arpfic/l_depth_r_depth_dx7_eurorack/README.md

# L&R Depth

This folder contains the hardware design and software for a **Left & Right (L&R) Depth module** with a breakpoint/plateau, inspired by the famous DX7 function from Yamaha synthesizers. The goal was to provide a eurorack module that can shape control voltages or signals with separate left/right “depth” ranges, plus an adjustable center plateau zone.

More photos coming soon !

## Hardware

- **Eurorack** (+12/-12V) format (see the [`Hardware`](Hardware/) folder).
- Exposes:
  - **CV input** for the main signal.
  - Pots/sliders for left/right depth and a central “plateau” adjustment.
  - Digital switches/buttons to toggle between **linear** and **exponential** shapes.
- Panel:

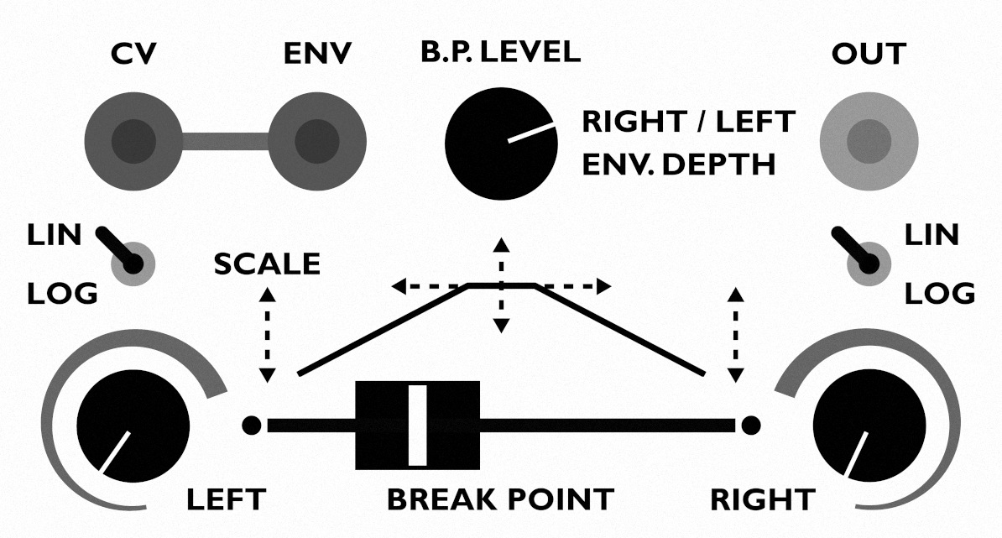
[picture p1: Hardware/lr_pannel.jpg]
LRDepth_pannel


- PCB:

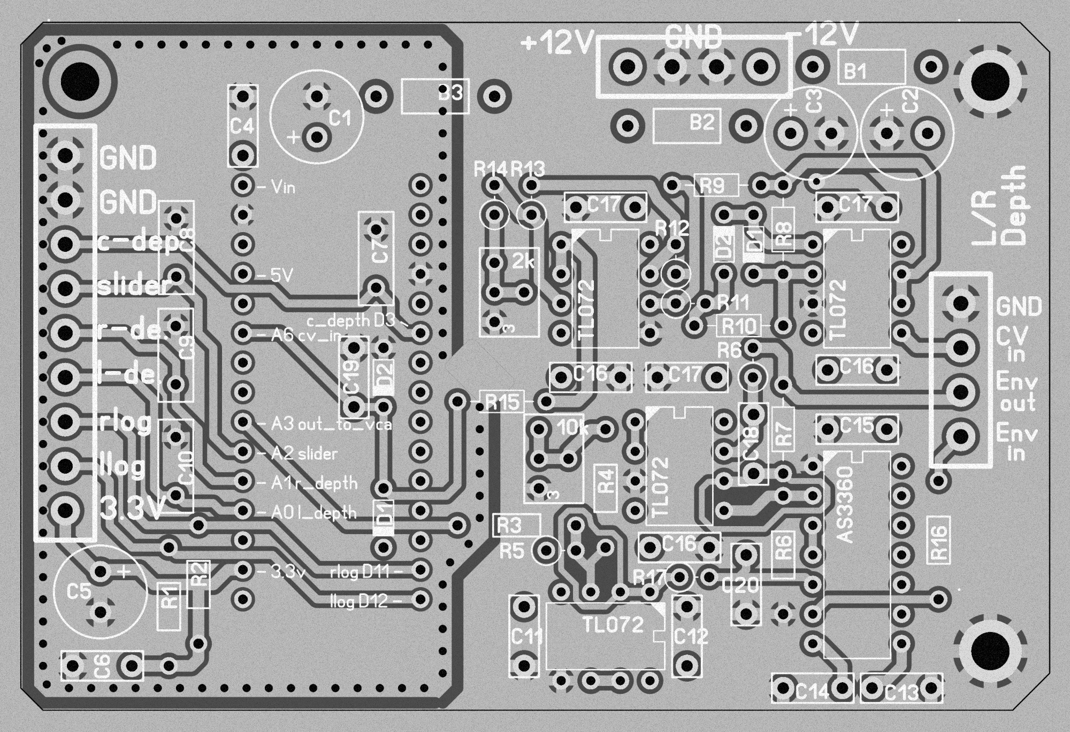
[picture p2: Hardware/lr_depth_top.jpg]
LRDepth_top

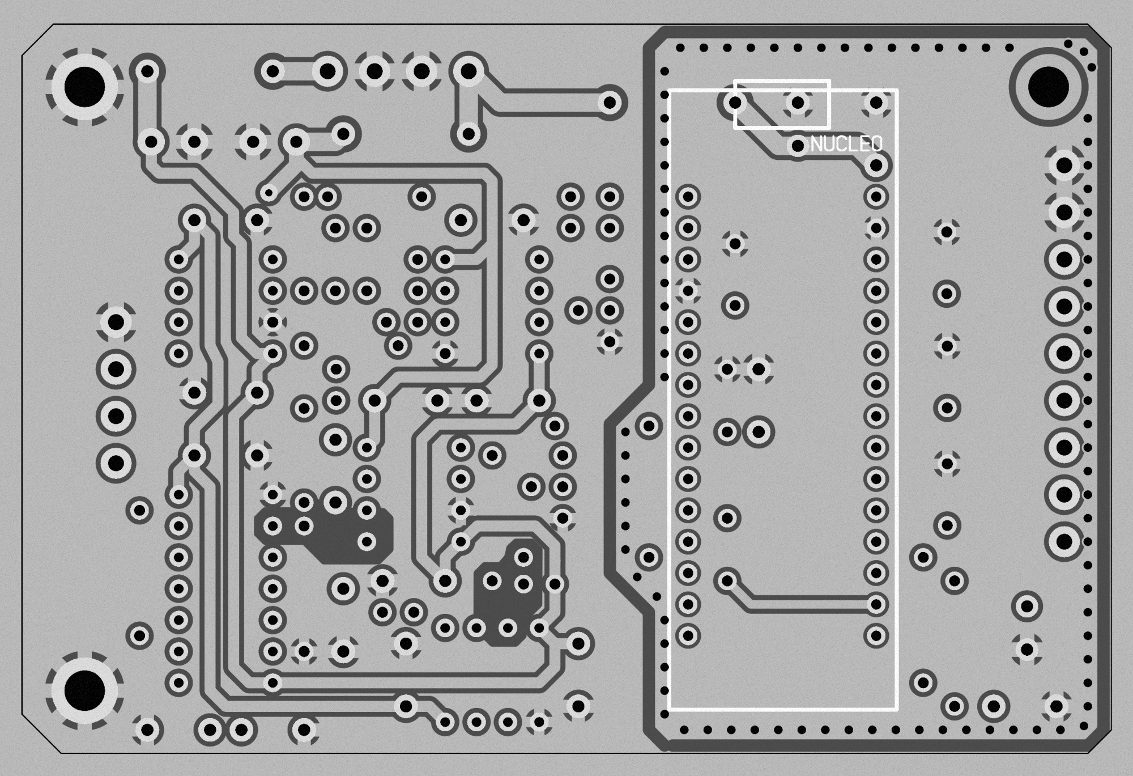
[picture p3: Hardware/lr_depth_bottom.jpg]
LRDepth_bottom


## Software

- Compiled under Mbed using a custom profile (e.g. -O3 optimizations) provided in this repository.

## Example Plots

Here are some example curves generated by the firmware, showing both **linear** and **exponential** transitions:

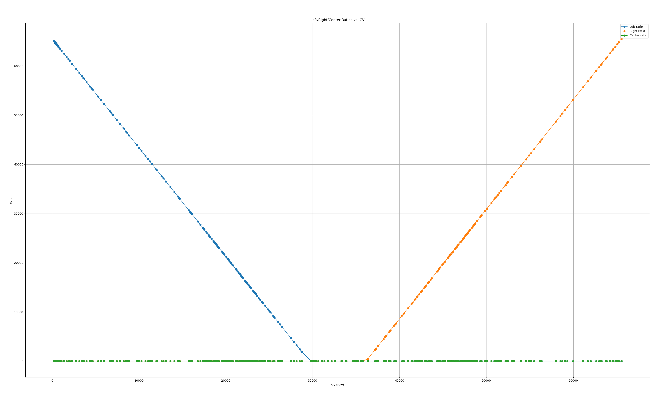
[picture p4: lin_final.png]
Linearcurve
  
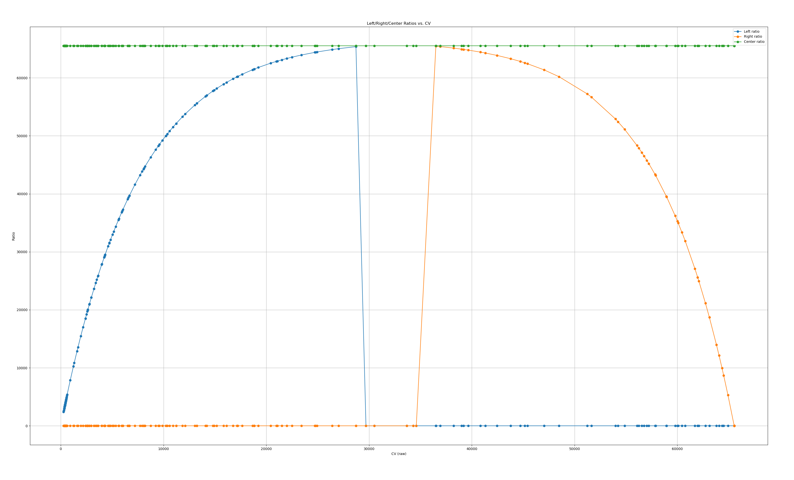
[picture p5: exp_w_c=4_final.png]
Expcurve
  
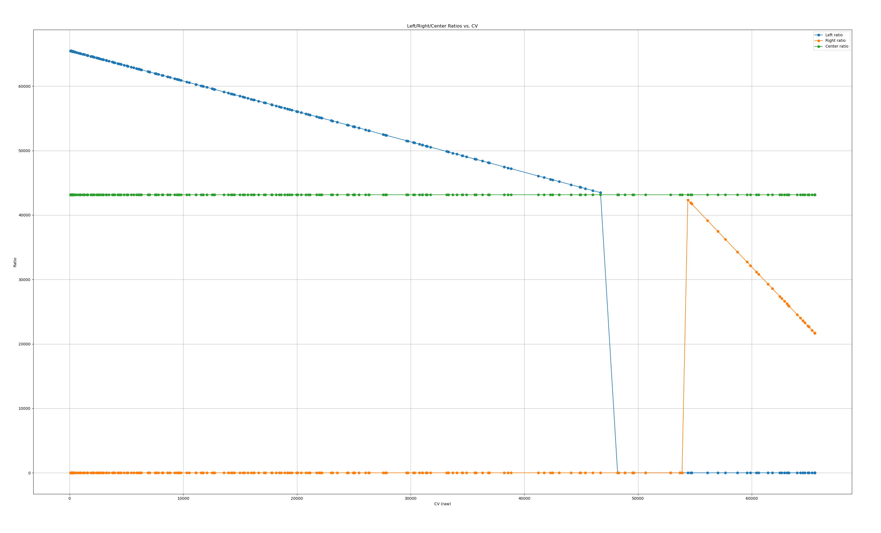
[picture p6: lin_other.png]
Linearother
  
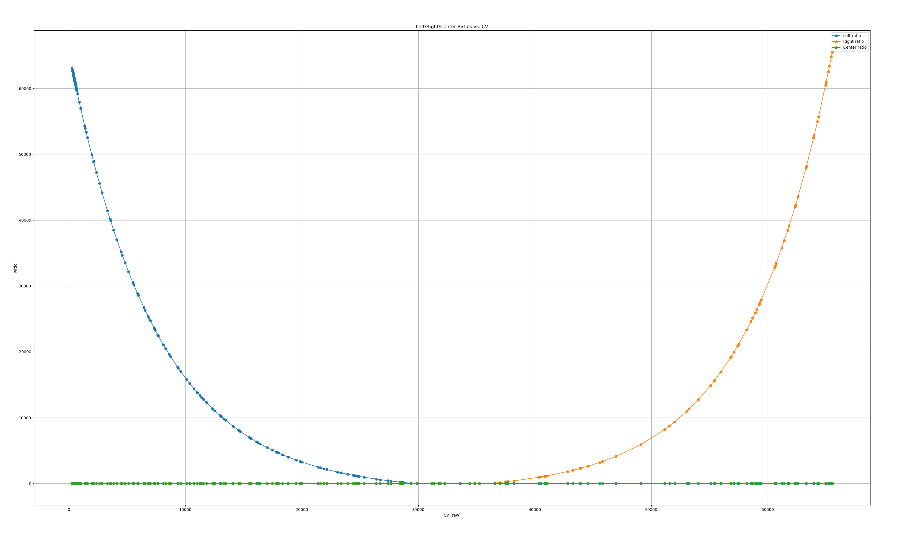
[picture p7: exp_other.png]
Expother

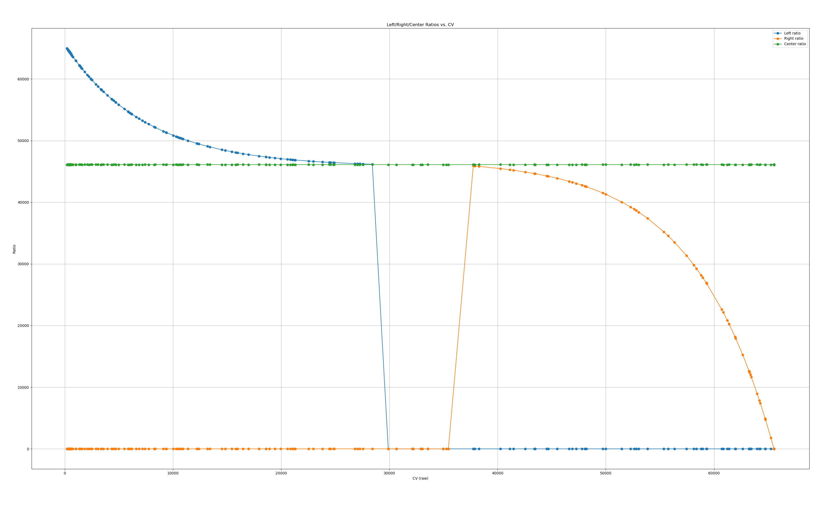
[picture p8: exp_other_2.png]
Expother2

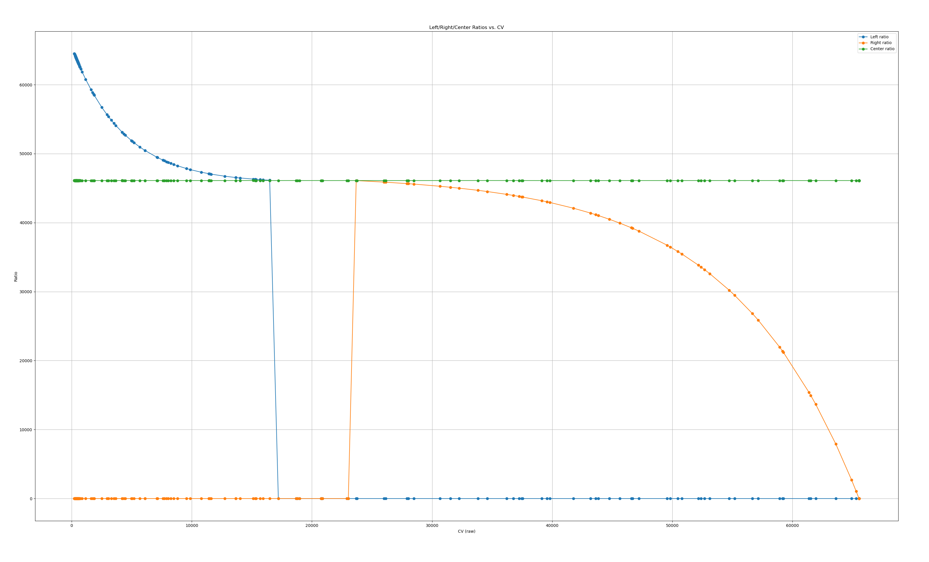
[picture p9: exp_other_3.png]
Expother3


## Notes, Limitations, and futures Improvements:

- **Re-implement center control so it affects only the center plateau** (reducing it without altering the side breakpoints), and apply inverted curves on the side transitions **[ok]**. 
- Mbed: It would be beneficial to migrate away from Mbed toward a lower-level library such as libopencm3 for more direct control.
- ADC (12-bit): Consider using an external ADC with higher resolution—likewise for the DAC—to achieve finer precision.
- Current Loop Speed (~10 kHz): The calculation loop runs at about 10,000 iterations per second, which can limit experimentation if you want to process signals beyond simple CV. To significantly increase throughput, implementing DMA on the ADC inputs would be essential.
- Tests show that floating-point operations are faster than integer operations on this platform.

---

## DX7 Reference

- On the Yamaha DX7, “L & R Depth” parameters control how certain amplitude segments transition on the left or right side of a breakpoint.

---

Principal code maintainer : Damien Leblois <damienleb@protonmail.com>
