arpfic/l_depth_r_depth_dx7_eurorack/Documentation/as3360_to_env_out.png

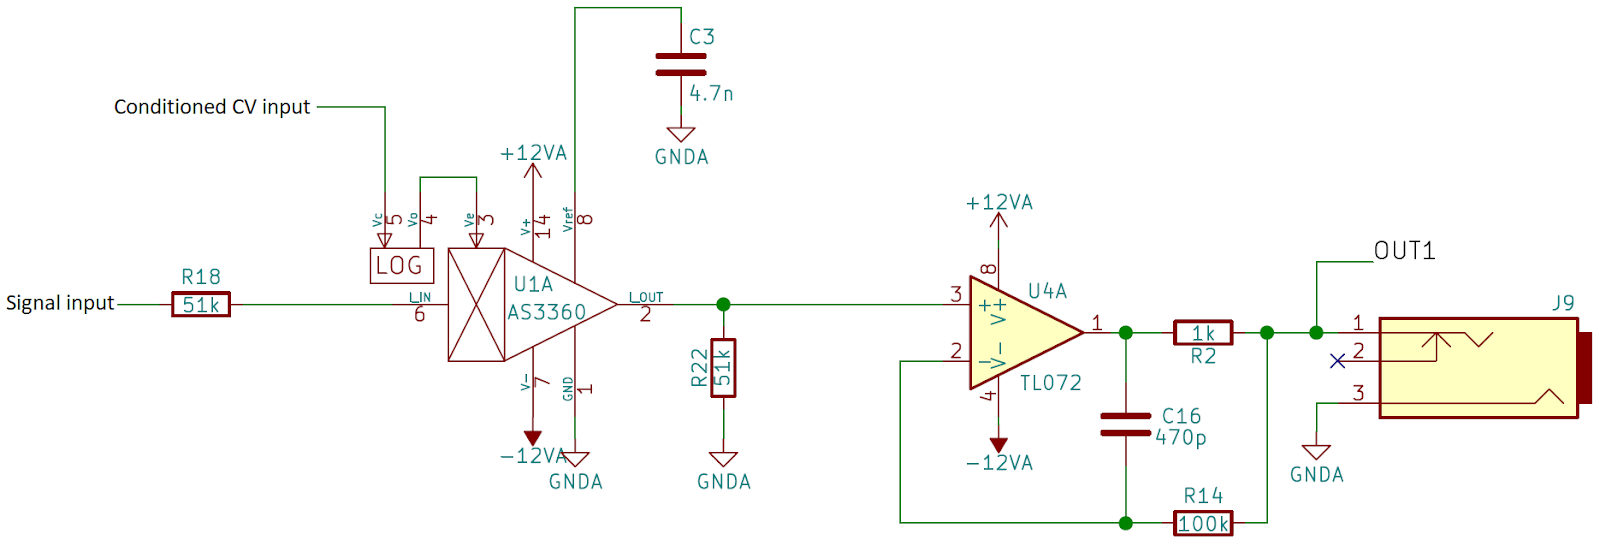
Documentation/as3360_to_env_out.png
