arpfic/l_depth_r_depth_dx7_eurorack/Documentation/cv_input_to_adc.png

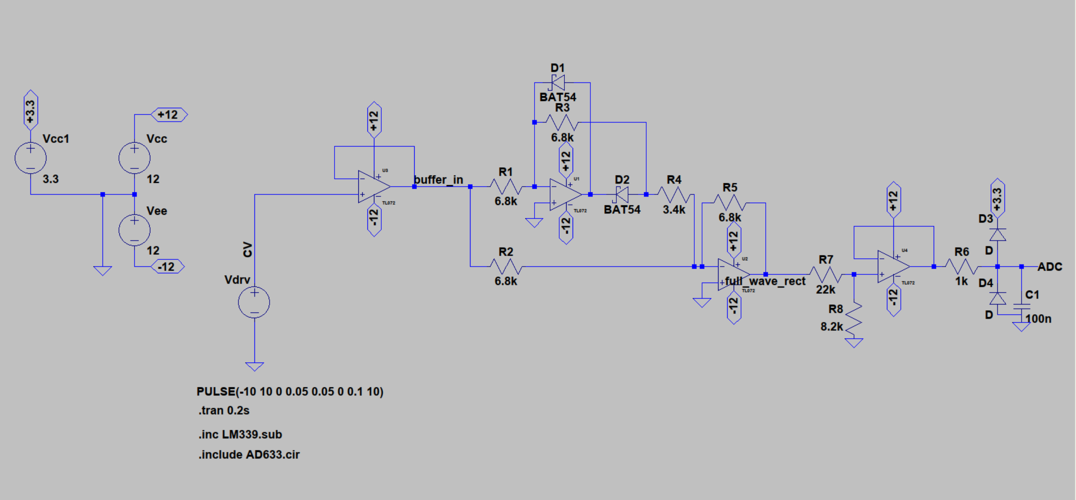
Documentation/cv_input_to_adc.png
