arpfic/l_depth_r_depth_dx7_eurorack/Documentation/dac_to_as3360.png

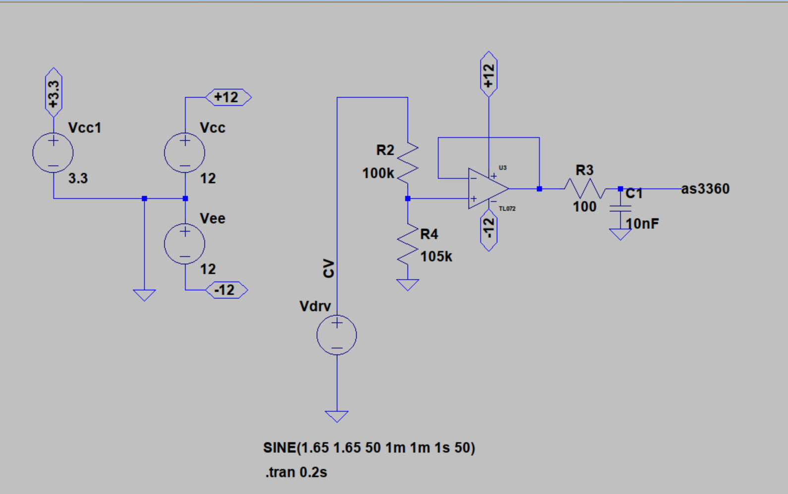
Documentation/dac_to_as3360.png
