arpfic/l_depth_r_depth_dx7_eurorack/Documentation/BOM.md

* Capa sur sliders :
10pF si pot = 10k
100pF si pot = 100k
=> 318Hz

* Filtrage du CV en sortie du MCU

* Séparation des masses et jonction en un point

* Ferrites et capa

* https://kassu2000.blogspot.com/2019/03/dual-vca.html

--
Ferrites x2
22pF C0G x2
10uF Electrolytic x2

AS3360
TL072 x2
BAT54 x2
1N4148 x2

Si noise, remplacer par :
https://www.mouser.fr/ProductDetail/Analog-Devices/OP275GPZ?qs=WIvQP4zGanhBjWhdN34Npg%3D%3D

https://os.mbed.com/forum/mbed/topic/1866/?page=1#comment-9285
https://os.mbed.com/users/chris/notebook/Getting-best-ADC-performance/
