arpfic/l_depth_r_depth_dx7_eurorack/Documentation/ldepth_rdepth_cv_to_dac.asc

C1: cap; 100n
D1: schottky; BAT54
D2: schottky; BAT54
D3: diode
D4: diode
R1: res; 6.8k
R2: res; 6.8k
R3: res; 6.8k
R4: res; 3.4k
R5: res; 6.8k
R6: res; 1k
R7: res; 22k
R8: res; 8.2k
U1: TL072
U2: TL072
U3: TL072
U4: TL072
Vcc1: voltage; 3.3
Vcc: voltage; 12
Vdrv: voltage; PULSE(-10 10 0 0.05 0.05 0 0.1 10)
Vee: voltage; 12
Named nets: 0, -12, +12, +3.3, CV, buffer_in, full_wave_rect, ADC
.tran 0.2s
.inc LM339.sub
.include AD633.cir
