arpfic/l_depth_r_depth_dx7_eurorack/Documentation/ldepth_rdepth_dac_to_as3360.asc

C1: cap; 10nF
R2: res; 100k
R3: res; 100
R4: res; 105k
U3: TL072
Vcc1: voltage; 3.3
Vcc: voltage; 12
Vdrv: voltage; SINE(1.65 1.65 50 1m 1m 1s 50)
Vee: voltage; 12
Named nets: 0, -12, +12, +3.3, CV, as3360
.tran 0.2s
.inc LM339.sub
.include AD633.cir
