arpfic/l_depth_r_depth_dx7_eurorack/(list of files, drawings)

Other design files:
Hardware/lr_depth.lay6
